jpfumo/KeckACSTest/GALIL/GALIL.kicad_pcb

## KiCad design GALIL/GALIL.kicad_pcb (2022-08-08)

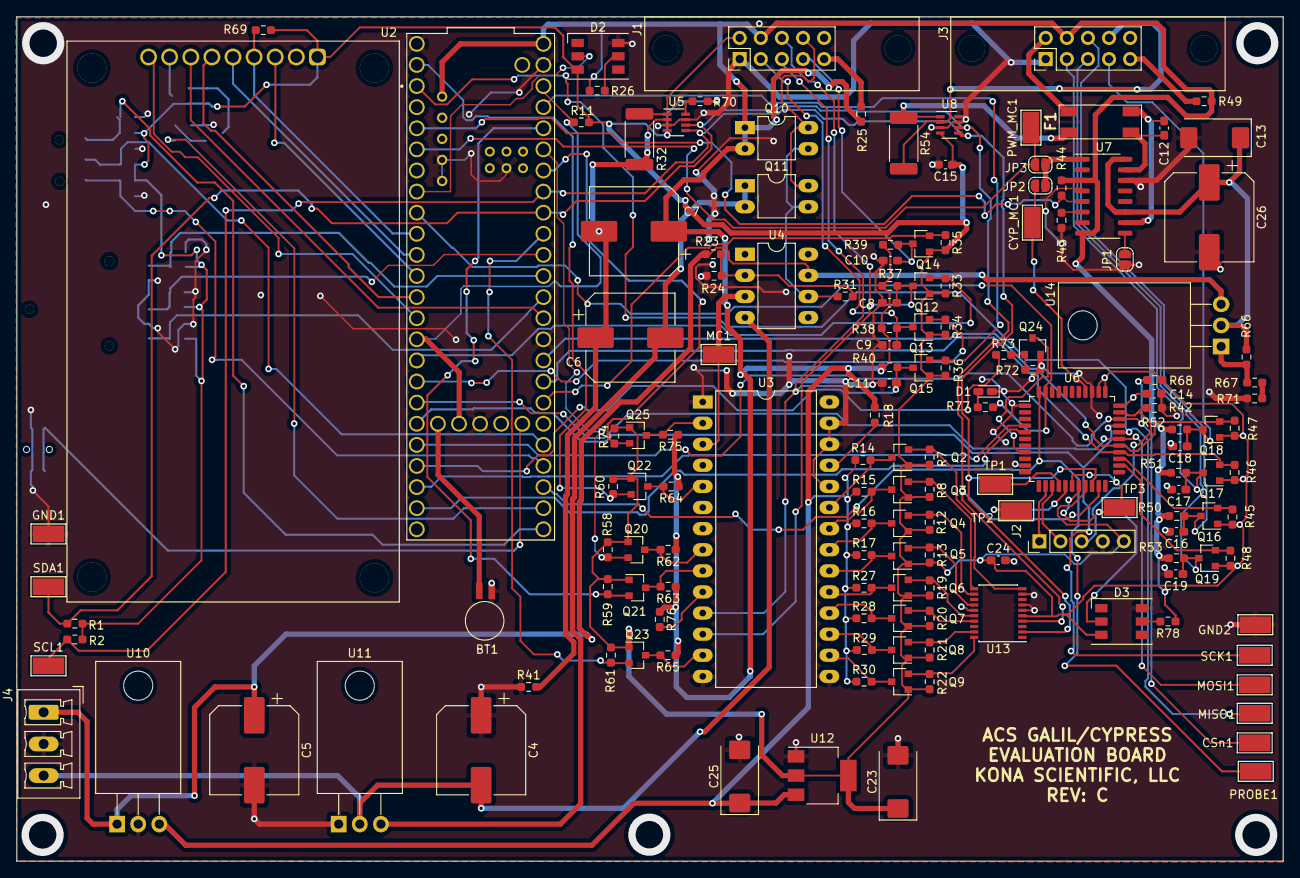
[picture p6: board GALIL.kicad_pcb from above]

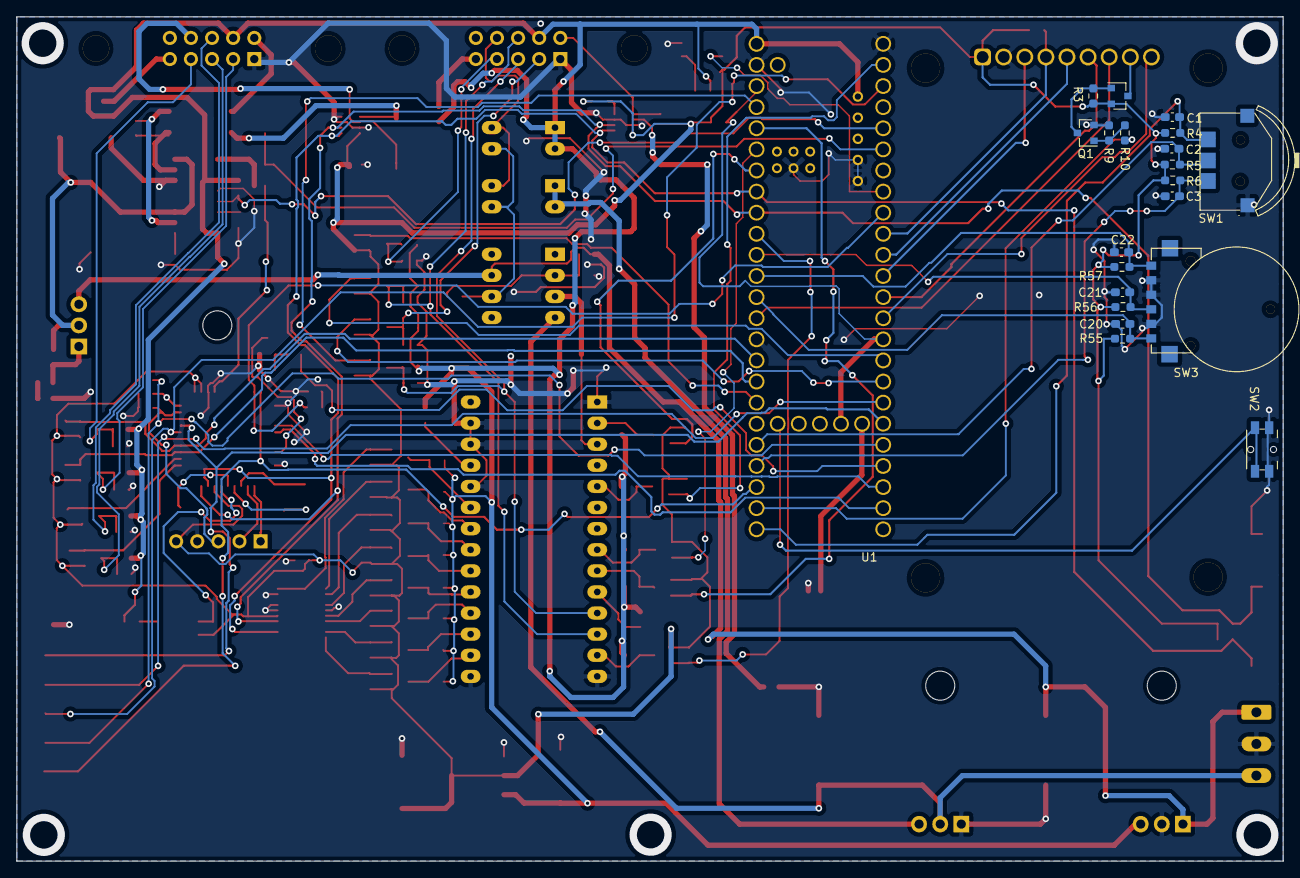
[picture p7: board GALIL.kicad_pcb from below]

Board: 2 copper layers, 152.4 x 101.6 mm, 173 parts (21 on the bottom side), 117 nets.

Parts:
BT1: Battery_Cell; BatteryHolder_Seiko_MS621F
C1, C2, C3: 0U1; C_0603_1608Metric_Pad1.08x0.95mm_HandSolder
C4, C5, C6, C7, C26: CP; CP_Elec_10x10.5
C8, C9, C10, C11, C16, C17, C18, C19, C20, C21, C22, C24: C; C_0603_1608Metric_Pad1.08x0.95mm_HandSolder
C12: 2200pF; C_0603_1608Metric_Pad1.08x0.95mm_HandSolder
C13: 740mF; CP_EIA-7343-15_Kemet-W
C14, C15: 1uF; C_0603_1608Metric_Pad1.08x0.95mm_HandSolder
C23, C25: CP; CP_EIA-7343-20_Kemet-V_Pad2.25x2.55mm_HandSolder
CSn1: CSn; TestPoint_Keystone_5019_Minature
CYP_MC1: TestPoint; TestPoint_Keystone_5019_Minature
D1: LED; LED_0603_1608Metric_Castellated
D2, D3: WS2812S; LED_WS2812_PLCC6_5.0x5.0mm_P1.6mm
F1: 744229; WE-SL575
GND1, GND2: TestPoint; TestPoint_Keystone_5019_Minature
J1, J3: Conn_01x10; StrutConn
J2: Conn_01x05; PinHeader_1x05_P2.54mm_Vertical
J4: Conn_01x03; PhoenixContact_MCV_1,5_3-G-3.81_1x03_P3.81mm_Vertical
JP1, JP2, JP3: SolderJumper_2_Open; SolderJumper-2_P1.3mm_Open_RoundedPad1.0x1.5mm
MC1: TestPoint; TestPoint_Keystone_5019_Minature
MISO1: MISO; TestPoint_Keystone_5019_Minature
MOSFET1: FDN358P; SOT-23
MOSI1: MOSI; TestPoint_Keystone_5019_Minature
PROBE1: PROBE; TestPoint_Keystone_5019_Minature
PWM_MC1: TestPoint; TestPoint_Keystone_5019_Minature
Q1, Q24: MMBT3904; SOT-23
Q2, Q3, Q4, Q5, Q6, Q7, Q8, Q9, Q12, Q13, Q14, Q15, Q16, Q17, Q18, Q19, Q20, Q21, Q22, Q23, Q25: BSS138; SOT-23
Q10: IRFD110; DIP-4_W7.62mm_LongPads
Q11: IRFD9102; DIP-4_W7.62mm_LongPads
R1, R2: 4K75; R_0603_1608Metric_Pad0.98x0.95mm_HandSolder
R3, R4, R5, R6, R9, R55, R56, R57, R68, R69, R72, R76: 10K0; R_0603_1608Metric_Pad0.98x0.95mm_HandSolder
R7, R8, R12, R13, R14, R15, R16, R17, R19, R20, R21, R22, R27, R28, R29, R30, R58, R59, R60, R61, R62, R63, R64, R65, R74, R75: R; R_0603_1608Metric_Pad0.98x0.95mm_HandSolder
R10, R73: 1K0; R_0603_1608Metric_Pad0.98x0.95mm_HandSolder
R11: DNP; R_0603_1608Metric_Pad0.98x0.95mm_HandSolder
R18, R24, R33, R34, R35, R36, R37, R38, R39, R40, R42, R44, R45, R46, R47, R48, R50, R51, R52, R53, R70: 10K; R_0603_1608Metric_Pad0.98x0.95mm_HandSolder
R23: 130K; R_0603_1608Metric_Pad0.98x0.95mm_HandSolder
R25, R49, R77: 120ohms 1/4W; R_0603_1608Metric_Pad0.98x0.95mm_HandSolder
R26, R78: 100R0; R_0603_1608Metric_Pad0.98x0.95mm_HandSolder
R31: 68K; R_0603_1608Metric_Pad0.98x0.95mm_HandSolder
R32: 1R0; R_2512_6332Metric_Pad1.40x3.35mm_HandSolder
R41: 0R0; R_0603_1608Metric_Pad0.98x0.95mm_HandSolder
R43: 5K; R_0603_1608Metric_Pad0.98x0.95mm_HandSolder
R54: 1.0; R_2512_6332Metric_Pad1.40x3.35mm_HandSolder
R66: 120; R_0603_1608Metric_Pad0.98x0.95mm_HandSolder
R67: 906; R_0603_1608Metric_Pad0.98x0.95mm_HandSolder
R71: 54; R_0603_1608Metric_Pad0.98x0.95mm_HandSolder
SCK1: SCK; TestPoint_Keystone_5019_Minature
SCL1: SCL; TestPoint_Keystone_5019_Minature
SDA1: SDA; TestPoint_Keystone_5019_Minature
SW1: SEL_SW
SW2: SW_Push; Panasonic_EVQPUL_EVQPUC
SW3: EVQ-WKA001
TP1, TP2, TP3: TP; TestPoint_Keystone_5019_Minature
U1: DEV-16771; teensy41
U2: TFT_LCD; TFT_DISP_2P2
U3: GALIL; DIP-28_W15.24mm_LongPads
U4: TL081; DIP-8_W7.62mm_LongPads
U5, U8: INA219AxDCN; SOT-23-8
U6: CY8C4245AXI-483; LQFP-44_10x10mm_P0.8mm
U7: SI8244; SO-16_3.9x9.9mm_P1.27mm
U10: LM7805_TO220; TO-220-3_Horizontal_TabDown
U11: LM7905_TO220; TO-220-3_Horizontal_TabDown
U12: LT1117-3.3; SOT-223-3_TabPin2
U13: PCF8574ATS; SSOP-20_4.4x6.5mm_P0.65mm
U14: LM350_TO220; TO-220-3_Horizontal_TabDown

Connections:
+3V3: C15.1, C23.1, C24.1, D2.3, D3.3, J2.5, MOSFET1.2, Q2.1, Q3.1, Q4.1, Q5.1, Q6.1, Q7.1, Q8.1, Q9.1, Q12.1, Q13.1, Q14.1, Q15.1, Q16.1, Q17.1, Q18.1, Q19.1, Q20.1, Q21.1, Q22.1, Q23.1, Q25.1, R1.1, R2.1, R3.1, R4.1, R5.1, R6.1, R7.1, R8.1, R11.1, R12.1, R13.1, R19.1, R20.1, R21.1, R22.1, R33.2, R34.2, R35.2, R36.2, R45.2, R46.2, R47.2, R48.2, R55.2, R56.2, R57.2, R58.1, R59.1, R60.1, R61.1, R68.1, R69.1, R70.2, R74.1, U2.1, U5.4, U6.19, U6.34, U6.35, U8.4, U12.2, U13.5
+5V: C7.1, C25.1, J1.4, J3.4, Q10.1, Q10.2, R14.1, R15.1, R16.1, R17.1, R18.2, R25.1, R26.1, R27.1, R28.1, R29.1, R30.1, R37.2, R38.2, R39.2, R40.2, R44.1, R49.1, R50.2, R51.2, R52.2, R53.2, R62.1, R63.1, R64.1, R65.1, R75.1, R76.1, R78.1, U1.5V, U1.VIN, U7.3, U7.8, U10.3, U12.3
+15V: C5.1, J4.1, R23.2, U4.7, U10.1, U14.3
-5V: C6.2, Q11.1, Q11.2, U11.3
-15V: C4.2, J4.3, U4.4, U11.2
BL_EN: MOSFET1.1, Q1.3, R3.2
CLED: D3.2, U6.18
CS: U1.10, U2.3
CYPRESS_PWM0: CYP_MC1.1, JP2.2, U6.37
CYP_CSn: CSn1.1, R68.2, U1.28, U6.31
CypressRST_MOT0: Q24.3, U6.8
Cypress_DebugReset0: J2.3, R42.1, U6.32
DC: U1.9, U2.5
ENC1_A: C19.1, J3.5, Q19.3, R53.1
ENC1_A_L: Q19.2, R48.1, U6.24
ENC1_B: C16.1, J3.6, Q16.3, R50.1
ENC1_B_L: Q16.2, R45.1, U6.25
ENC1_HOME: C17.1, J3.3, Q17.3, R51.1
ENC1_HOME_L: Q17.2, R46.1, U1.40, U6.26
ENC1_HOME_OUT: U1.30, U6.4
ENC1_INDEX: C18.1, J3.7, Q18.3, R52.1
ENC1_INDEX_L: Q18.2, R47.1, U1.41, U6.27
ENC1_INDEX_OUT: U1.31, U6.5
ENC1_MTR1: F1.3, R54.1, U8.1
ENC1_MTR2: F1.4, J3.2
ENC1_MTR_RTN: JP1.1, U7.9
ENC2_A: C11.1, J1.5, Q15.3, R40.1, U3.11
ENC2_A_L: Q15.2, R36.1, U1.23
ENC2_B: C8.1, J1.6, Q12.3, R37.1, U3.12
ENC2_B_L: Q12.2, R33.1, U1.24
ENC2_HOME: C9.1, J1.3, Q13.3, R38.1
ENC2_HOME_L: Q13.2, R34.1, U1.25
ENC2_INDEX: C10.1, J1.7, Q14.3, R39.1
ENC2_INDEX_L: Q14.2, R35.1, U1.39
ENC2_MTR1: J1.8, Q10.4, Q11.4
ENC2_MTR2: J1.2, R32.1, U5.1
GALIL_CLK: Q22.2, R60.2, U1.0
GALIL_CLK_HV: Q22.3, R64.2, U3.5
GALIL_DEC: Q20.2, R58.2, U1.21
GALIL_DEC_HV: Q20.3, R62.2, U3.8
GALIL_ERR_FLG: Q25.2, R74.2, U1.20
GALIL_ERR_FLG_HV: Q25.3, R75.2, U3.2
GALIL_INC: Q21.2, R59.2, U1.22
GALIL_INC_HV: Q21.3, R63.2, U3.9
GALIL_PE0: Q2.2, R7.2, U13.10
GALIL_PE1: Q3.2, R8.2, U13.11
GALIL_PE2: Q4.2, R12.2, U13.12
GALIL_PE3: Q5.2, R13.2, U13.14
GALIL_PE4: Q6.2, R19.2, U13.16
GALIL_PE5: Q7.2, R20.2, U13.17
GALIL_PE6: Q8.2, R21.2, U13.19
GALIL_PE7: Q9.2, R22.2, U13.20
GALIL_RSTn: Q23.2, R61.2, U1.17
GALIL_RSTn_HV: Q23.3, R65.2, U3.13
GND: BT1.2, C1.1, C2.1, C3.1, C4.1, C5.2, C8.2, C9.2, C10.2, C11.2, C13.2, C14.1, C15.2, C16.2, C17.2, C18.2, C19.2, C20.2, C21.2, C22.2, C23.2, C24.2, C25.2, C26.2, D1.1, D2.6, D3.6, GND1.1, GND2.1, J1.1, J2.4, J3.1, J4.2, JP1.2, Q1.2, Q24.2, R9.2, R24.1, R41.1, R42.2, R43.2, R71.2, R72.2, SW1.5, SW2.1, SW3.2, SW3.3, SW3.5, U1.GND1, U1.GND2, U1.GND3, U1.GND4, U1.GND5, U1.USB_GND1, U1.USB_GND2, U2.2, U3.1, U3.14, U3.15, U3.24, U3.26, U3.27, U5.3, U5.7, U6.1, U6.10, U6.36, U7.4, U7.14, U8.3, U8.7, U8.8, U10.2, U11.1, U12.1, U13.6, U13.7, U13.9, U13.15
GNDPWR: C6.1, C7.2, R32.2, R41.2, U5.2
HV_GALIL_PE0: Q2.3, R14.2, U3.23
HV_GALIL_PE1: Q3.3, R15.2, U3.22
HV_GALIL_PE2: Q4.3, R16.2, U3.21
HV_GALIL_PE3: Q5.3, R17.2, U3.20
HV_GALIL_PE4: Q6.3, R27.2, U3.19
HV_GALIL_PE5: Q7.3, R28.2, U3.18
HV_GALIL_PE6: Q8.3, R29.2, U3.17
HV_GALIL_PE7: Q9.3, R30.2, U3.16
I2C_SCL: R2.2, SCL1.1, U1.19, U5.5, U6.20, U8.5, U13.2
I2C_SDA: R1.2, SDA1.1, U1.18, U5.6, U6.21, U8.6, U13.4
LED: R77.2, U1.7, U6.43
MISO: U1.12, U2.9
MISO1: MISO1.1, U1.1, U6.29
MOSI: U1.11, U2.6
MOSI1: MOSI1.1, U1.26, U6.28
Motor_Cntrl: MC1.1, U3.3, U4.3
NEOPIXEL: D2.2, U1.6
unnamed: BT1.1, U1.VBAT
unnamed: C12.1, F1.1, U7.10
unnamed: C12.2, F1.2, U7.15
unnamed: C14.2, U6.33
unnamed: D1.2, R77.1
unnamed: D2.5, R26.2
unnamed: D3.5, R78.2
unnamed: J1.9, R25.2
unnamed: J2.1, U6.13
unnamed: J2.2, U6.14
unnamed: J3.8, R54.2, U8.2
unnamed: J3.9, R49.2
unnamed: JP2.1, JP3.1, U7.1
unnamed: MOSFET1.3, U2.8
unnamed: Q1.1, R9.1, R10.2
unnamed: Q10.3, Q11.3, R31.1, U4.6
unnamed: Q24.1, R72.1, R73.2
unnamed: R10.1, U1.34
unnamed: R11.2, U1.3.3V_1, U1.3.3V_2, U1.3.3V_3
unnamed: R18.1, U3.25
unnamed: R23.1, R24.2, R31.2, U4.2
unnamed: R43.1, U7.6
unnamed: R66.2, R67.2, U14.1
unnamed: R67.1, R71.1
unnamed: R70.1, U5.8
unnamed: R73.1, U1.29
unnamed: R76.2, U3.10
unnamed: SW2.2, U1.ON/OFF
unnamed: TP1.1, U6.15
unnamed: TP2.1, U6.16
unnamed: TP3.1, U6.17
PROBE: PROBE1.1, U1.35, U6.44
PWM_DISABLE_MOT0: R44.2, U1.3, U7.5
PWM_MC: JP3.2, PWM_MC1.1, U1.4
ROT_A: C22.1, R57.1, SW3.1, U1.15
ROT_B: C20.1, R55.1, SW3.6, U1.14
ROT_SEL: C21.1, R56.1, SW3.4, U1.16
RSTn: R69.2, U1.8, U2.4
SCK: U1.13, U2.7
SCK1: SCK1.1, U1.27, U6.30
SW_DWN: C3.2, R6.2, SW1.4, U1.36
SW_SEL: C2.2, R5.2, SW1.3, U1.37
SW_UP: C1.2, R4.2, SW1.2, U1.33
V_MOTOR: C13.1, C26.1, R66.1, U7.11, U7.16, U14.2
