jpfumo/KeckACSTest/(commit log)

2022-08-20 Checkpoint
    Implemented controls for Cypress device.
2022-08-20 Checkpoint2
    Second checkpoint of the day. Fix timestamps of Cypress recording.
    [KeckACS.h, KeckACSwBRMS.ino]
